SanliFaez/FAIR-Battery/site_structured_sorting/FAIR Battery project/READ_ME.txt

This folder contains the folders that will be the side navigation bar for the Fair Battery Project section of the quarto site.
