SanliFaez/FAIR-Battery/docs/source/index.rst

****************************
Welcome to FAIR-Battery docs
****************************

FAIR-Battery Logo

*FAIR-Battery* is [short sentence about vision and goals]

FAIR-Battery is meant to be:
-----------------------
+ Open-source: all designs and data that is useful for further development will be shared
+ Scalable: both small and medium scale installations are supported and considered in new designs
+ Versatile: alternative chemistries or material resources will be accommodated as much as possible

FAIR-Battery is NOT meant to:
------------------------
+

You can find the code of this package on `Github <https://github.com/sanlifaez/FAIR-Battery>`_.
The documentation is hosted on `Read The Docs <https://readthedocs.org/projects/FAIR-Battery>`_.

.. toctree::
   :maxdepth: 4
   :caption: Further in the docs:

   introduction
   unboxing
   FAIR-Battery 101
   technical drawings
   software installation
   testing a unit
   troubleshooting
   materials database
   customize
   contribute

Acknowledgement
===============
+

Other resources
=========================================
+

If you know of a package that should be added to this list, please do not hesitate to drop us a message.
