SanliFaez/FAIR-Battery/Attic/docs/unboxing.rst

****************************
Unboxing the FAIR-Battery [WIP]
****************************

Getting started
---------------

Welcome to your FAIR-Battery! Below is a list of everything you should have to get started.

**Included:**

    + Testing Hardware

**Not Included:**

    + Chemicals
