SanliFaez/FAIR-Battery/FAIR_BATTERY_WEBSITE_26-5-25/images/batterij_uitleg1.pdf

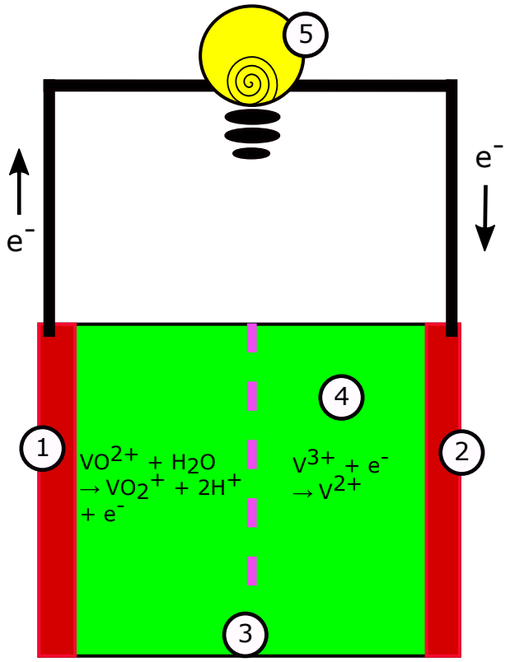
[picture p13: figure]

Legend
1. Anode
2. Cathode
3. Membrane
4. Electrolyte
5. Device
