SanliFaez/FAIR-Battery/docs/source/FAIR-Battery 101.rst

****************
FAIR-Battery 101 [WIP]
****************

...
