SanliFaez/FAIR-Battery/FAIR_BATTERY_WEBSITE_26-5-25/images/batterij_uitleg1.jpg

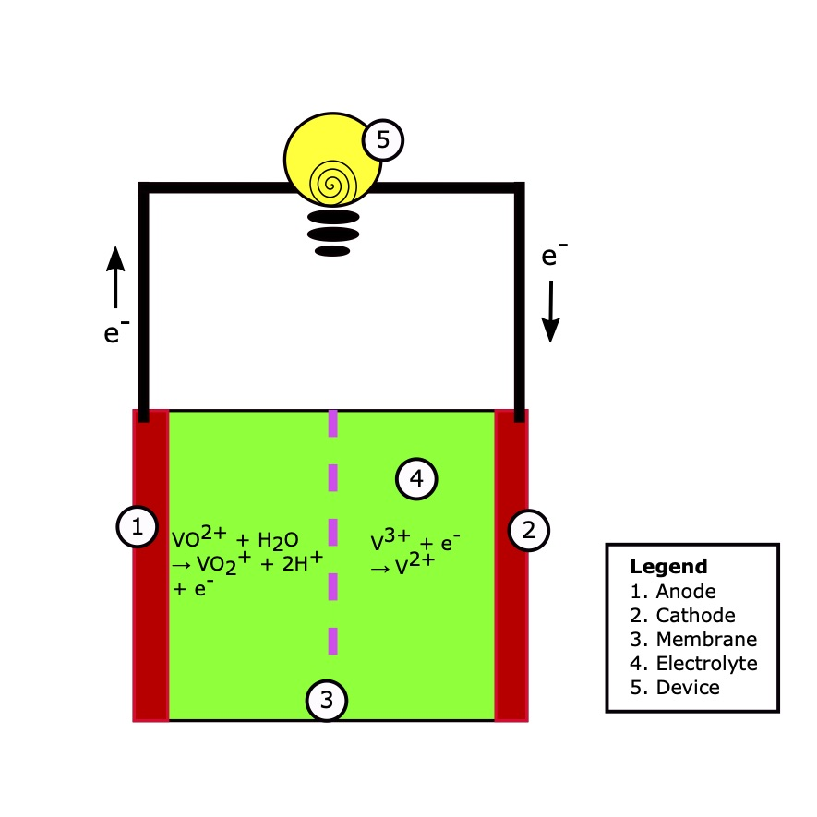
FAIR_BATTERY_WEBSITE_26-5-25/images/batterij_uitleg1.jpg
