SanliFaez/FAIR-Battery/FAIR_BATTERY_WEBSITE_26-5-25/images/jig.png

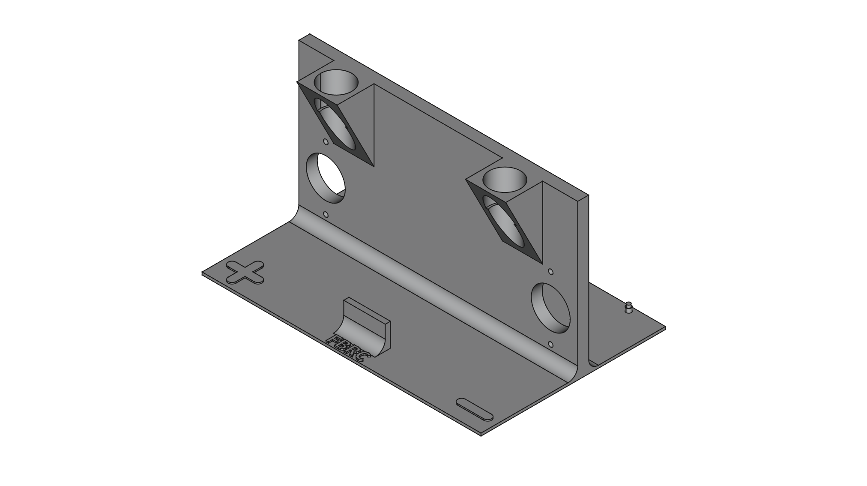
FAIR_BATTERY_WEBSITE_26-5-25/images/jig.png
