SanliFaez/FAIR-Battery/FAIR_BATTERY_WEBSITE_26-5-25/images/reservoir.png

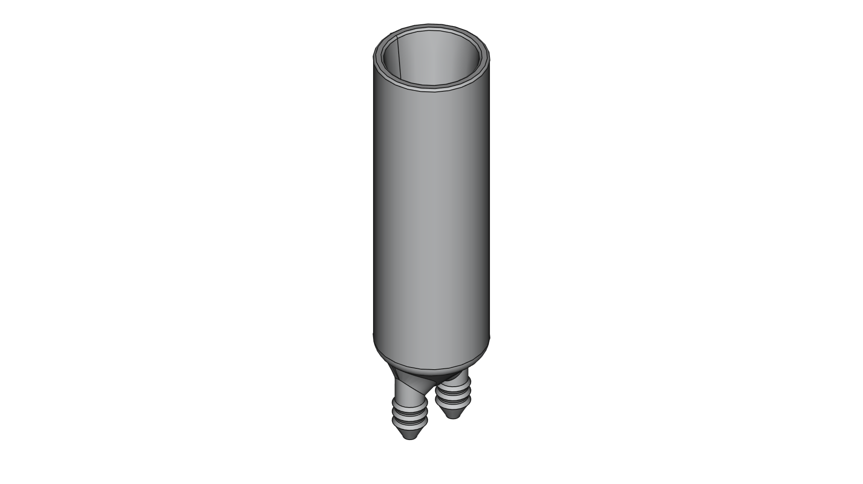
FAIR_BATTERY_WEBSITE_26-5-25/images/reservoir.png
