SanliFaez/FAIR-Battery/site_structured_sorting/FAIR Battery project/Build Intructions/fbrc/Bill of Materials/barbed_fittings.md

---
PartData:
    Specs:
        Thread: M6
        Barb: For 4mm ID flexible tubing
    Suppliers:
         AliExpress:
            PartNo: Use this link
            Link: ''
         Amazon:
            PartNo: Use this link
            Link: ''

---

## Barbed fittings

Also try searching for "Pagoda fittings" for other suppliers
