SanliFaez/FAIR-Battery/site_structured_sorting/FAIR Battery project/Build Intructions/fbrc/Bill of Materials/brass.md

---
PartData:
    Specs:
        Dimensions: 50 mm x 50 mm x 0.8 mm

#    Suppliers:
#         AliExpress:
#            PartNo: Use this link
#            Link: 'https://www.aliexpress.com/item/1005004374432193.html'

---

## Brass current collectors
