SanliFaez/FAIR-Battery/site_structured_sorting/FAIR Battery project/Build Intructions/fbrc/Bill of Materials/conductive_felt.md

---
PartData:
    Specs:
        Material: Conductive Graphite Felt
        Thickness:  3.2 mm or 1/8 inch
    Suppliers:
        Fisher Scientific:
            PartNo:  AA43199RY 
            Link: 'https://www.fishersci.com/shop/products/carbon-felt-3-18mm-0-125in-thick-99-0-thermo-scientific/AA43199RY#?
keyword=043199'

---

# Conductive Graphite (Carbon) Felt
The Fisher Scientifics carbon felt is commonly used in academic studies. There are other more affordable suppliers on AliExpress and specialty carbon product suppliers in various regions worldwide. The felt needs to be conductive, this technically means it has to have been "graphitized" and thermally treated at a sufficiently high temperature, though sometimes it may still be sold as "carbon felt" as in the Fisher Scientific product.
