SanliFaez/FAIR-Battery/site_structured_sorting/FAIR Battery project/Build Intructions/fbrc/Bill of Materials/drivers.md

---
PartData:
    Specs:
        Current Rating: TODO
        Voltage Rating: 24 V
        Outputs: 2
    Suppliers:
        AliExpress:
            PartNo: Use this link
            Link: 'https://www.aliexpress.com/item/33012645746.html'
        Amazon (NL):
            PartNo: Use this link
            Link: 'https://www.amazon.nl/-/en/ICQUANZX-Controller-Module-Bridge-Stepper/dp/B07MY33PC9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'
---

# L298N motor driver for pump

This is a generic motor driver circuit to drive the pumps, which accept a PWM input and control the individual pump duty cycles.
 
