SanliFaez/FAIR-Battery/site_structured_sorting/FAIR Battery project/Build Intructions/fbrc/Bill of Materials/gaskets.md

---
PartData:
    Specs:
        Material: Silicone
        Thickness: 0.5 mm
    Suppliers:
        Amazon:
            PartNo: Link
            Link: 'https://www.amazon.fr/dp/B09HZ52B8H'
---

# Gasket material

This is used to cut blocking and pass-through gaskets.
