SanliFaez/FAIR-Battery/site_structured_sorting/FAIR Battery project/Build Intructions/fbrc/Bill of Materials/nonconductive_felt.md

---
PartData:
    Specs:
        Material: Polypropylene
    Suppliers:
        Amazon:
            PartNo:  AA43199RY 
            Link: 'https://www.fishersci.com/shop/products/carbon-felt-3-18mm-0-125in-thick-99-0-thermo-scientific/AA43199RY#?
keyword=043199'

---

# Nonconductive Graphite

This is used as a spacer on the negative side, to allow metal to plate. It also can be used as a spacer on the cathode side, to prevent clogging of the cell in the event of solid iodine precipitation.
