SanliFaez/FAIR-Battery/site_structured_sorting/FAIR Battery project/Build Intructions/fbrc/Bill of Materials/orings.md

---
PartData:
    Specs:
        Material: FKM or similar
        Dimensions: 5mm OD, 3 mm ID
    Suppliers:
        RS Components:
            PartNo: 196-5616 
            Link: 'https://uk.rs-online.com/web/p/gaskets-o-rings/1965616'

---

# O-rings
Used to seal barbed fittings on machined cell bodies, alternatively fittings could be heat-welded in place permanently after threading
