SanliFaez/FAIR-Battery/site_structured_sorting/FAIR Battery project/Build Intructions/fbrc/Bill of Materials/pstat.md

---
PartData:

    Suppliers:
        PCBWay:
            PartNo: Use this link
            Link: 'https://www.pcbway.com/project/shareproject/MyStat_Potentiostat_9df57df2.html'
---

# Potentiostat

The MYSTAT potentiostat, link is to PCBWay project.

Control software can be found [here](https://codeberg.org/FBRC/mystat/src/branch/master/python).
