SanliFaez/FAIR-Battery/site_structured_sorting/FAIR Battery project/Build Intructions/fbrc/Bill of Materials/pumps.md

---
PartData:
    Specs:
        Voltage: 24 V
        Flowrate: Approx. 100 to 200 mL/min
    Suppliers:
        AliExpress:
            PartNo: Use this link
            Link: 'https://www.aliexpress.com/item/1005002886964746.html'
        Amazon (NL):
            PartNo: Use this link
            Link: 'https://www.amazon.nl/-/en/500213799/dp/B0BGL9VQ11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'

---

# Diaphragm pumps
