SanliFaez/FAIR-Battery/site_structured_sorting/FAIR Battery project/Build Intructions/fbrc/Bill of Materials/separator_sheet.md

---
PartData:
    Specs:
        Material: Matte Photo Paper
        Weight:  230 g/m²
    Suppliers:
        Amazon:
            PartNo: Use this link
            Link: 'https://www.amazon.fr/gp/product/B07JYT7BN8/'
---

# Separator material



This is good enough separator material to get started, though a real batter separator like Daramic is preferred (but hard to obtain).
