SanliFaez/FAIR-Battery/site_structured_sorting/FAIR Battery project/Build Intructions/fbrc/Bill of Materials/septa.md

---
PartData:
    Specs:
        Material: Silicone
        Size: 19/22
    Suppliers:
         Amazon:
            PartNo: Use this link
            Link: 'https://www.amazon.fr/dp/B0BR3P56GR?ref=ppx_yo2ov_dt_b_fed_asin_title'

---

## Reservoir septa stoppers
