SanliFaez/FAIR-Battery/site_structured_sorting/FAIR Battery project/Build Intructions/fbrc/Bill of Materials/tubing.md

---
PartData:
    Specs:
        Material: PVC or Silicone
        Inner Diameter: 4 mm
        Outer Diameter: 6 mm
---

# Tubing
