SanliFaez/FAIR-Battery/Attic/Build/_readme.md

# Open-Hardware-Documentation-Template
In this subfolder you can store all the (binary) design files that are needed for the hardware. Use subfolders for more complex assemblies.
