SanliFaez/FAIR-Battery/Make Ready For Quarto/FAIR-Battery Project/Main Page/FAIR_Battery_Main.md

## Ready to Build Your Own FAIR-Battery?

Welcome to the FAIR-Battery project page! Here, you'll find everything you need to design, build, and test your very own battery. Whether you're a beginner or have some prior knowledge of battery technology, this guide will walk you through the process step by step.

### What to Expect
We have structured this guide into clear sections to help you navigate through the project with ease. By following along, you will gain both theoretical and practical insights into battery design and testing.

1. **Battery 101** – A fundamental introduction to battery chemistry. Before you start building, it's important to understand the basic principles that make batteries work. 

2. **Components** – A breakdown of the parts you will be assembling for your battery. Each component plays a crucial role in the overall function of the battery, and we will briefly explain their purposes and how they interact with one another.

3. **Build** – Now that you have the necessary knowledge, it's time to construct your battery! For this, we will guide you to the Flow Battery Test Cell (FBRC) website, where you will find detailed step-by-step manufacturing instructions, including material specifications, assembly techniques and more.

4. **Testing** – Once your battery is assembled, you’ll need to check if it is working correctly. We will outline key testing procedures, including voltage measurements, capacity assessments and more.

5. **Troubleshooting** – Encountering problems during assembly or testing? Don't worry! This section will provide solutions to frequently encountered issues and offer guidance on diagnosing and fixing potential errors.

6. **Beyond** – Haven't had enough and want to do more? We will give you some additional challenges you can do to improve your knowledge!

---

We hope this guide makes your journey into battery building exciting and accessible. Let’s get started and bring your FAIR-Battery to life!
