SanliFaez/FAIR-Battery/Attic/Build/DevKit/_readme.md

# Flow battery development kit 

We collaborate with the [Flow Bettery Research Collective](https://fbrc.dev/) 

The updates for their development kit is [posted here](https://fbrc.codeberg.page/rfb-dev-kit/)

For a nice write up about our collaboration and the workshop we hosted at the FLOW4U Battery Conference 2024, check this [blogpost](https://fbrc.dev/posts/Flow4U-conference/)

FBRC's Development Kit is released under CERN-OHL-S-2.0.
