SanliFaez/FAIR-Battery/Attic/Build/Electrolyte/_readme.md

# Electrolyte recipes

Redox-Flow batteries can run on different types of electrolytes. 
We post here only the recipe's that we have tested with our development kit.
