SanliFaez/FAIR-Battery/Attic/Build/MyStat/_readme.md

# Affordable Potentiostat for Testing a cell 

We have successfully tested our system with the [MyStat](https://www.pcbway.com/project/shareproject/MyStat_Potentiostat_9df57df2.html) potentiostat. 
This is an opensource potentiostat released under the GNU General Public License v.3.

This folder contains the design for a housing for the board.
