SanliFaez/FAIR-Battery/site_structured_sorting/FAIR Battery project/Build Intructions/fbrc/index.md

# Building a benchtop flow battery test cell with a zinc-iodide electrolyte



>i **Note** 
>i
>i This kit is intended for educational and R&D use only, not for actual energy storage applications. That will happen later, check out our [roadmap](https://fbrc.dev/about.html#roadmap) to see when.
>i
>i Project homepage is at https://fbrc.dev, source code for this documentation is [here](https://codeberg.org/FBRC/RFB-dev-kit).



This bill of materials can be found [here]{BOM}.

If you're starting from scratch, you need to [fabricate](fabrication.md) and source everything needed for using this flow battery test cell.

If you already have all the required components and materials, you can directly [prepare the power electronics](electronics.md), [assemble the cell](cell_assembly.md), [assemble the jig](jig_assembly.md), prepare the [electrolyte](electrolyte.md), and then begin [testing](testing.md). After an experiment, you should [clean up](cleanup.md) your setup and [analyze](analysis.md) the data you obtained.

1. [.](fabrication.md){step}

2.  [.](electronics.md){step}

3. [.](cell_assembly.md){step}

4. [.](jig_assembly.md){step}

5. [.](leak_test.md){step}

6. [.](electrolyte.md){step}

7. [.](testing.md){step}

8. [.](cleanup.md){step}

9. [.](analysis.md){step}
