SanliFaez/FAIR-Battery/Make Ready For Quarto/READ_ME.txt

The folders in this folder are the options that will be given in the top navigation bar of the quarto website.
