SanliFaez/FAIR-Battery/Attic/Software/RelayBased_Testing_Software/README.md

# Welcome to the FAIR-Battery Testing Package!
For information and documentation please see: [readthedocs](https://fair-battery.readthedocs.io/en/latest/index.html).

Link: https://fair-battery.readthedocs.io/en/latest/index.html
