SanliFaez/FAIR-Battery/Attic/Results/_readme.md

# Open-Hardware-Documentation-Template
For measurement or functional devices, it is good to report some results as a benchmark for others who try to replicate the project.
Try to make it easy for others to reproduce your results by proper versioning and comments that explain the logic behind and conditions of making each reported result.
