SanliFaez/FAIR-Battery/Attic/Software/RelayBased_Testing_Software/examples/101_project/test_test.csv

# Time (s) | Cell Voltage (V) | Current (mA)
9.910 | -0.024 | 6.810
19.911 | -0.022 | 3.720
24.700 | 0.004 | 43.080
