SanliFaez/FAIR-Battery/site_structured_sorting/FAIR Battery project/Testing Your Unit/fbrc/Analyzing and storing the experimental data/analysis.md

---
Details:
    Thumbnail: images/image_1735837218047_0.png
    Time: Tens of minutes
    Skills:
      - Running Python code
---
<!-- There should be only one Header per page. You do not need to use all the keys -->
# Analyzing and storing the experimental data

🎉 Congrats! You have made it far. 🎉

>!! **Warning** 
>!!
>!! **Ensure your data is backed up.**

We process our data in Python notebooks. Use the code in this blog post [here](https://fbrc.dev/posts/progress-update-dev-kit/), point it to your data file generated from cycling, and run the analysis. We'd really like it if you'd upload your data and analyis code, too!

Then let us know of your experiment in the [forum](https://fbrc.nodebb.com/)!
