SanliFaez/FAIR-Battery/Attic/Software/RelayBased_Testing_Software/examples/101_project/current_test.csv

# Time (s) | Cell Voltage (V) | Current (mA)
0.000 | 3.763 | 0.000
0.100 | 3.764 | 0.000
0.200 | 3.763 | 0.000
0.300 | 3.763 | 0.000
0.400 | 3.763 | 0.000
0.500 | 3.763 | 0.000
0.600 | 3.763 | 0.000
0.700 | 3.763 | 0.000
0.800 | 3.763 | 0.000
0.900 | 3.763 | 0.000
1.000 | 3.762 | 0.000
1.100 | 3.762 | 0.000
1.200 | 3.762 | 0.000
1.300 | 3.763 | 0.000
1.400 | 3.763 | 0.000
1.500 | 3.763 | 0.000
1.600 | 3.763 | 0.000
1.700 | 3.763 | 0.000
1.800 | 3.763 | 0.000
1.900 | 3.763 | 0.000
2.000 | 3.763 | 0.000
2.100 | 3.763 | 0.000
2.201 | 3.763 | 0.000
2.300 | 3.764 | 0.000
2.400 | 3.763 | 0.000
2.500 | 3.763 | 0.000
2.600 | 3.763 | 0.000
2.700 | 3.763 | 0.000
2.800 | 3.764 | 0.000
2.900 | 3.764 | 0.000
3.000 | 3.764 | 0.000
3.100 | 3.764 | 0.000
3.200 | 3.764 | 0.000
3.300 | 3.764 | 0.000
3.400 | 3.764 | 0.000
3.500 | 3.764 | 0.000
3.600 | 3.765 | 0.000
3.700 | 3.763 | 0.000
3.800 | 3.763 | 0.000
3.900 | 3.763 | 0.000
4.000 | 3.764 | 0.000
4.100 | 3.764 | 0.000
4.200 | 3.764 | 0.000
4.300 | 3.764 | 0.000
4.400 | 3.763 | 0.000
4.500 | 3.764 | 0.000
4.600 | 3.764 | 0.000
4.700 | 3.764 | 0.000
4.800 | 3.764 | 0.000
4.900 | 3.764 | 0.000
5.000 | 3.764 | 0.000
5.100 | 3.763 | 0.000
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
