SanliFaez/FAIR-Battery/FAIR_BATTERY_WEBSITE_26-5-25/bug_report.md

**Describe the bug** A clear and concise description of what the bug is.

**To Reproduce** Steps to reproduce the behavior: 1. Go to 'examples' 2. Set pythonpath variable '....' 3. Run script '....' 4. See error '...'

**Expected behavior** A clear and concise description of what you expected to happen.

**Screenshots** If applicable, add screenshots to help explain your problem.

**System Information** - OS: \[e.g. Windows\] - OS Version \[e.g. Windows 10\] - Python Version \[e.g. 3.9.1\]

**Additional context** Add any other context about the problem here.
