SanliFaez/FAIR-Battery/(threads)

Thread 2 (2021-09-30):

[BUG] < No module named 'Battery_Testing_Software'>

ColinBolle, 2021-09-30:
**Describe the bug**
A clear and concise description of what the bug is.
When I try to run the battery 101 test file it says: No module named 'Battery_Testing_Software' while the folder is clearly there.
I have run the setup.py and everything is correctly installed. A fellow student tried making a temporary python path but it doesn't fix things.

**To Reproduce**
Steps to reproduce the behavior:
1. Run the BatteryTest_View.py

**Expected behavior**
The file should run but since it cannot import everything it doesn't.

**Screenshots**

**System Information**
 - OS: Windows 10
- Python 3.8.11 as was installed via the setup.py file from the labphew gitlab

Cinbarker, 2021-09-30:
Hi @ColinBolle, this is indeed caused by the pythonpath not being set.
Try run this line in a terminal:

`python -c "import sys; print(sys.path)" `

If the path was set correctly this should print the path to the Battery_Testing_Software folder.
Note: in the above command, if ‘python’ doesn’t work, try ‘python3’

Cinbarker, 2021-10-09:
How is it going with this issue @ColinBolle? I put a bit more to help with this issue here:
[ImportError: No module named ‘Battery_Testing_Software’](https://fair-battery.readthedocs.io/en/latest/troubleshooting.html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)

Closed 2021-10-18.

Thread 4 (2021-10-18):

Displaying Coulomb in/out the battery

ColinBolle, 2021-10-18:
**Is your feature request related to a problem? Please describe.**
No.

**Describe the solution you'd like**
We would like a feature in the display element that shows the amount of Coulomb that got taken out or put into the battery when measuring voltage over a shunt resistance such that the current is known through the relation I = voltage (measured by the AD2)/shunt_resistance_value. In our setup we have defined a negative voltage for discharging and a positive voltage for charging. We calculate the amount of Coulomb with I*time_step so when discharging we want to display a negative amount of Coulomb and when charging we want to display a positive amount, which follows from the way we calculate the current and how we have constructed our circuit.

**Describe alternatives you've considered**
We have written a piece of code which manually loads in the exported raw data and calculates the total amount of coulomb after a complete charge/discharge cycle. However, we would now like to display it in real time.

**Additional context**
This is our [circuit](https://git.science.uu.nl/UED2021/Experiment_Design_2021/-/blob/master/subprojects/Flowmasters_ColinTeun/Charge_Discharge_Circuit.PNG) and [this code](https://git.science.uu.nl/UED2021/Experiment_Design_2021/-/blob/master/subprojects/Flowmasters_ColinTeun/Code/current_calculation.py) is used to perform the calculation.

Closed 2025-05-26.
