SanliFaez/FAIR-Battery/(commit log)

2021-06-30 refine UI and update functionality accordingly
    [current_test.csv]
2021-09-06 update docs
    [current_test.csv]
2021-09-23 add schematic
2021-09-23 add schematic info
2021-10-04 add signal for finished editing resistance
2021-10-04 round resistance to possible value when done editing spinbox, en/disable more UI elements during test
2022-07-19 add pyc to gitignore
    [test_test.csv]
2022-11-15 In docs/Toms_docs new files on testing, battery build and theory have been added.
    The following files have been added:
    - Battery_Build-up: This file gives information on the build up of a battery and explains the different parts
    - Plan_for_Vanadium Electrolyte: This file gives a synthesis of a vanadium electrolyte and contains relevant theory for the synthesis
    - Stability_Electrode: This file contains information on how to test if an electrode is stable enough to use in the battery. However, this file is far from finished.
    - First_testing_and_charging: This file contains information on the first tests which can be performed on a battery. This testing also requires charging. Tests which are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
2022-12-13 Changes to exising protocols and additon of a new testing protocol
    - In both the documents Battery Build Up and Plan for Vanadium Electrolyte the ±-sign in reaction 2 was wrong. This is corrected.
    - The folder Charge_Discharge_Testing has been added. This is the most recent testing protocol which can be performed on a battery cell.
    - The protocol in Plan for Vanadium Electrolyte has been altered
2022-12-13 Corrected error in Charge_Discharge_Testing_Updated
    In Charge_Discharge_Testing there was a mistake in how to determine the capacity. The right way to generate plots using the script will be added.
2022-12-19 Changes to Charge_Discharge_Testing_Updated.
    - Small changes have been made to the markdown file. There is still some reviewing which needs to be done on this file.
    - A python script has been added that can plot data from test from Charge_Discharge_Testing_Updated
2024-04-26 Update README.md
    minor grammatical edits and an update on the current state of the hardware.
2024-04-26 Create News and Progress
    Created a new page for news and progress and added a first news item about the flow battery workshop in Eindhoven. This updated needs to be further expanded upon.
2024-04-26 Update README.md
    added the FBRC to a new collaborators section. Linked the existing FBRC Codeberg repository to the battery hardware section.
2024-06-20 updating readme and folder structure
    [current_test.csv, test_test.csv]
2025-03-25 branch otmar reordering
    [current_test.csv, test_test.csv]
2025-04-03 Update Planned_site_structure.md
    I extended the structure of Battery 101, the rest look good to me. It would be nice to also reserve a place for miscellaneous (previous) activities, that do not yet have a place in the main structure
2025-05-26 Current site files
